Jaut-76/6AQ5-12AX7-stereo-amplifier/12AX7 6AQ5 amp final design.xlsx

Components | 89
Collated Components:
Item | Qty | Reference(s) | Value |  |  | Mouser number | Ebay
1 | 4 | C1, C2, C7, C10 | 20 UF | y |  | 75-TVA1608-E3
2 | 4 | C3, C4, C8, C9 | 25 UF 25V | y |  | 75-TE1207
3 | 4 | C5, C6, C13, C14 | 0.1 UF | y |  | 598-104MWR400K
4 | 2 | C11, C12 | 0.0033 UF | y | 3300pf | 598-332MPW400K
5 | 2 | C15, C16 | 180 PF | y |  | 810-FG24C0G2W181JNT6
6 | 2 | C17, C18 | 0.22 UF | y |  | 598-224MWR400K
7 | 2 | C19, C20 | 270 UF 450V | ebay |  | na | https://www.ebay.co.uk/itm/251902384596?
8 | 1 | C21 | 22 UF 450V | y |  | 80-ESK226M450AM7AA
9 | 2 | C22, C23 | 4.7 UF | y |  | 598-475TTA450M (https://www.mouser.co.uk/ProductDetail/598-475TTA450M)
10 | 2 | C24, C25 | C
11 | 2 | C26, C27 | 0.047 UF | y |  | 539-150400V.047K
12 | 2 | C28, C29 | 22 Uf 100v | y |  | 598-226TTA100M
13 | 2 | D1, D2 | 1N4007 | y |  | 583-RL1N4007-T
14 | 1 | F1 | Fuse | home
15 | 1 | J1 | L PHONO IN | y |  | 179-RCJ-035
16 | 1 | J2 | R PHONO IN | x
17 | 1 | J3 | Mains in | home
18 | 1 | J4 | L AUX 1 | x
19 | 1 | J7 | R AUX 1 | x
20 | 1 | J8 | L SPK OUT | y |  | 474-PRT-09739
21 | 1 | J9 | R SPK OUT | y |  | 474-PRT-09740
22 | 1 | LA1 | Lamp | ebay |  |  | https://www.ebay.co.uk/itm/185698490495?
23 | 2 | R1, R2 | PICKUP RES | y |  | 603-CFR50SJT-26-47K
24 | 4 | R3, R4, R11, R12 | 2700 | y |  | 603-CFR-50JR-52-2K7
25 | 4 | R5, R6, R9, R10 | 0.1 M | y |  | 603-MFR50SJT-52-100K
26 | 2 | R7, R8 | 39000 | y |  | 603-FCR50SJT-52-39K (https://www.mouser.co.uk/ProductDetail/603-FCR50SJT-52-39K)
27 | 2 | R13, R14 | 0.47 M | y |  | 603-CFR50SJT-52-470K
28 | 2 | R15, R16 | 15000 1W | y |  | 594-5083NW15K00J
29 | 2 | R17, R18 | 0.68 M | y |  | 603-CFR50SJT-26-680K (https://www.mouser.co.uk/ProductDetail/603-CFR50SJT-26-680K)
30 | 2 | R20, R21 | 22000 | y |  | 660-CF1/2CT52R223J
31 | 1 | R23 | 250 Ohm 10W | y |  | 588-20J250E
32 | 2 | R24, R25 | 4.7K | y |  | 603-CFR50SJR-52-4K7 (https://www.mouser.co.uk/ProductDetail/603-CFR50SJR-52-4K7)
33 | 2 | R26, R29 | 2.2K | y |  | 603-CFR50SJR-52-2K2
34 | 2 | R27, R28 | 220 | y |  | 603-CFR50SJT-52-220R
35 | 2 | R30, R31 | 150K | y |  | 603-CFR50SJR-52-150K (https://www.mouser.co.uk/ProductDetail/603-CFR50SJR-52-150K)
36 | 2 | R32, R33 | 2.7K | y |  | 603-CFR-50JR-52-2K7
37 | 2 | R34, R35 | 510K | y |  | 603-CFR50SJT-26-510K
38 | 2 | R36, R37 | 300 2W | y |  | 603-FMP200JT-52-300R
39 | 1 | R38 | 150 ohm 6W | y |  | 71-G006150R0JE12
40 | 2 | RV1, RV2 | 100K | y |  | 313-2420F-100K
41 | 1 | SW1 | POWER SPST | home
42 | 1 | SW2 | STBY SPST | home
43 | 1 | SW3 | SW_DPDT_x2 | tube town |  |  |  | Tube-Town Store - Alpha step switch 2-pole / 6 positions (https://www.tube-town.net/ttstore/alpha-stufendrehschalter-2-polig-6-positionen.html)
44 | 1 | T1 | Mains transformer | home
45 | 2 | T2, T3 | 5K Pri - 8 Sec | home
46 | 3 | U1, U2, U3 | ECC83 | home
47 | 2 | U4, U5 | 6AQ5 | home
 |  |  | chassis | tube town |  |  |  | Tube-Town Store - Chassis AL 1444-17132 (https://www.tube-town.net/ttstore/chassis-al-1444-17132.html)
 |  |  | b9a | tube town |  |  |  | Tube-Town Store - Socket Noval Belton, Chassis VT9-ST-2 (https://www.tube-town.net/ttstore/product_info.php?no_boost=1)
 |  |  | b7a | tube town |  |  |  | Tube-Town Store - Socket 7-pin ceramic chassis - 7EK (https://www.tube-town.net/ttstore/sockel-7-polig-keramik-chassis-7ek.html)
 |  |  | knobs | tube town |  |  |  | Tube-Town Store - Button Chickenhead domed, black (https://www.tube-town.net/ttstore/knopf-chickenhead-gewoelbt-schwarz.html)
