Jaut-76/6AQ5-12AX7-stereo-amplifier/12AX7 6AQ5 amp final design.kicad_sch

## KiCad design 12AX7 6AQ5 amp final design.kicad_sch (2023-09-06)

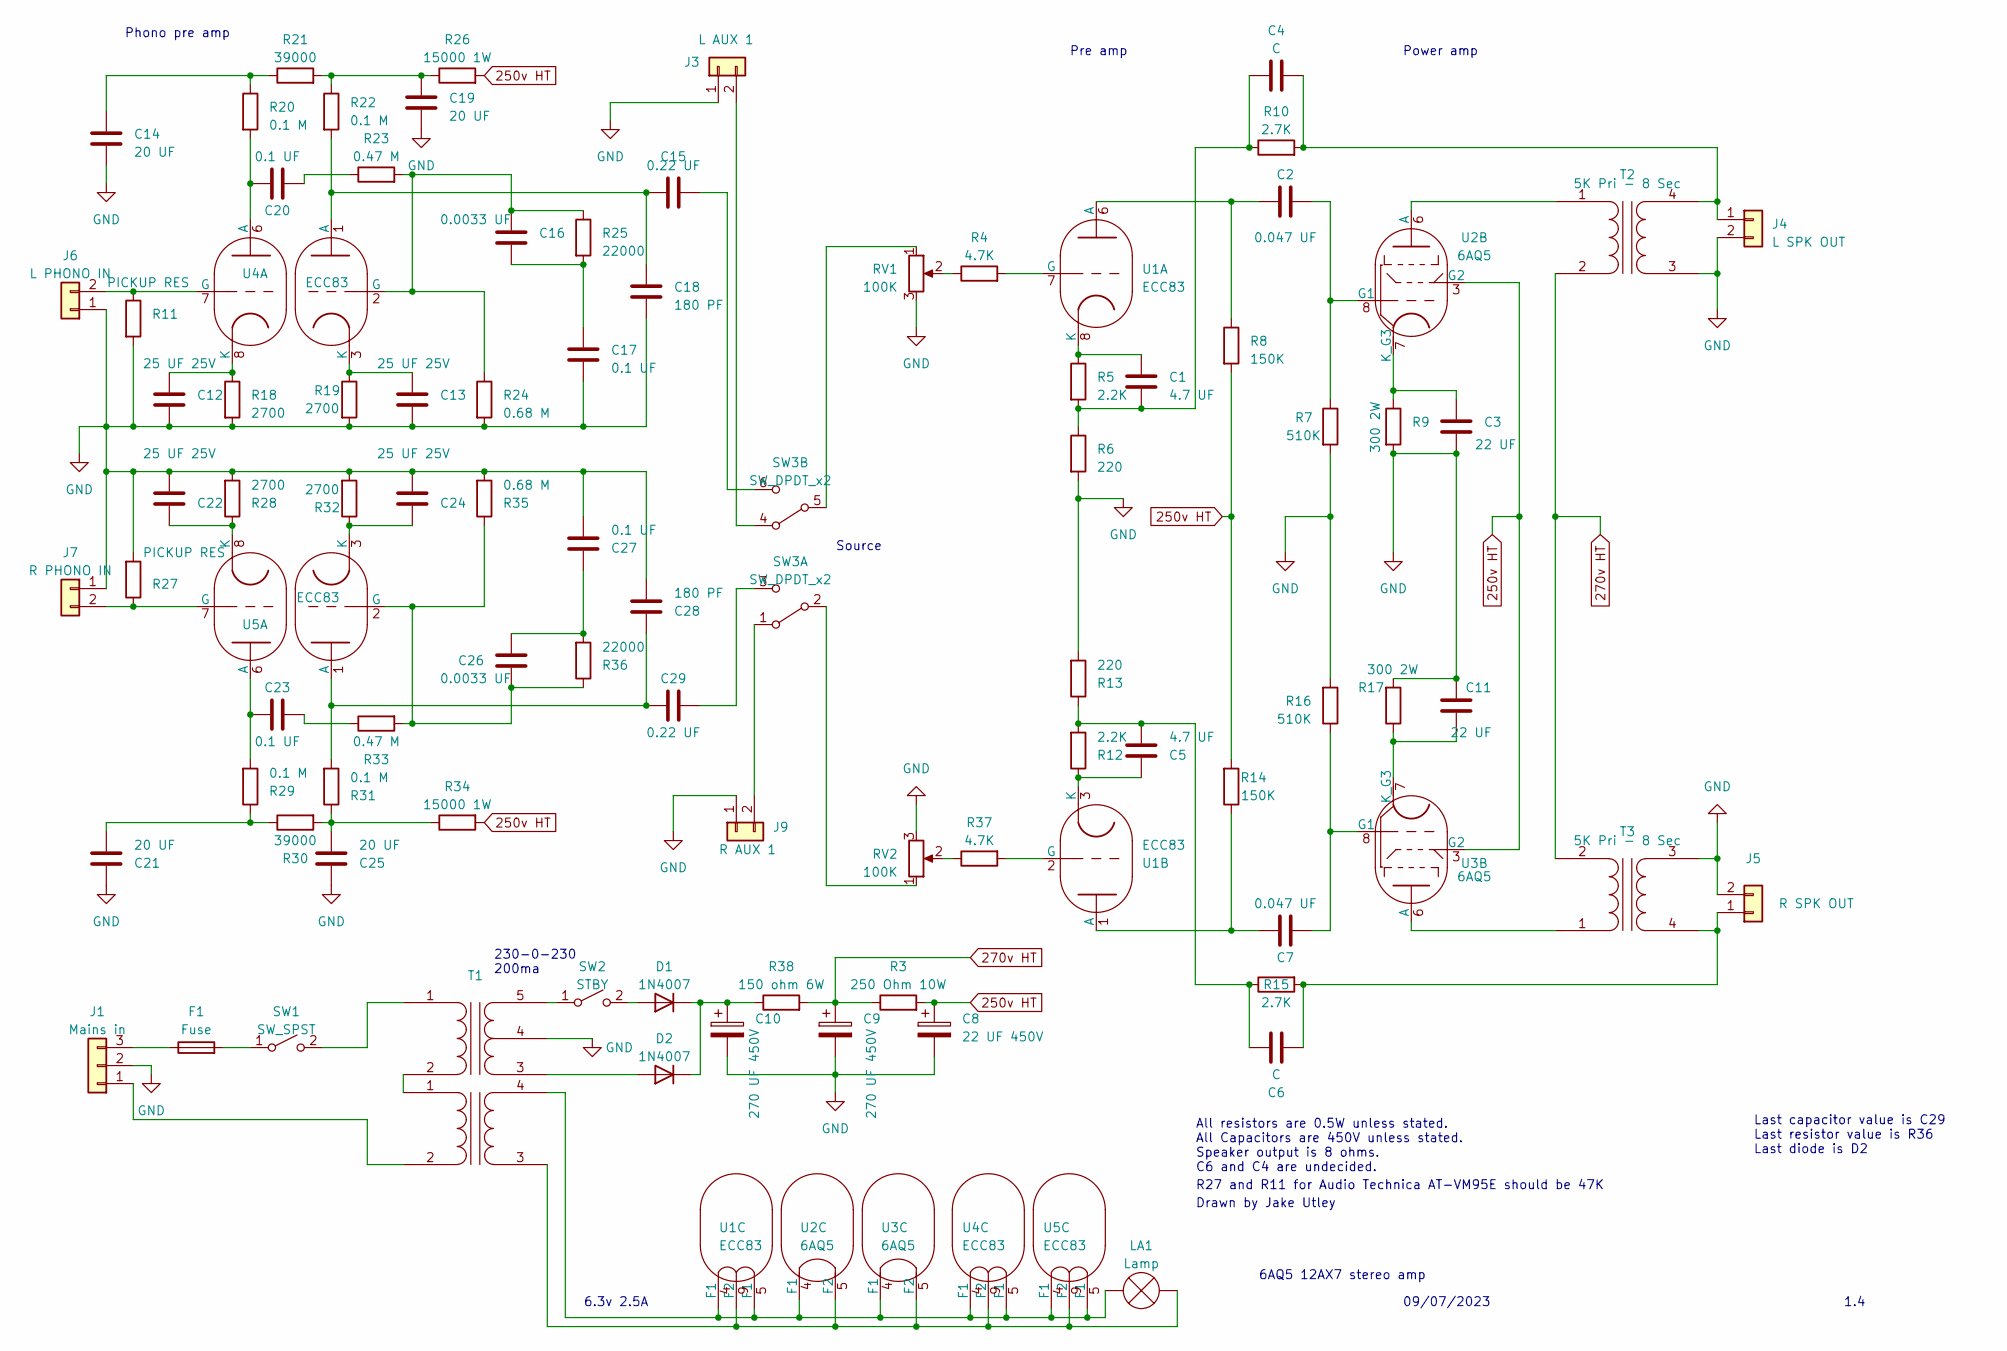
[picture p1: schematic 12AX7 6AQ5 amp final design.kicad_sch]

Parts:
C1, C5: 4.7 UF
C2, C7: 0.047 UF
C3, C11: 22 UF
C4, C6: C
C8: 22 UF 450V
C9, C10: 270 UF 450V
C12, C13, C22, C24: 25 UF 25V
C14, C19, C21, C25: 20 UF
C15, C29: 0.22 UF
C16, C26: 0.0033 UF
C17, C20, C23, C27: 0.1 UF
C18, C28: 180 PF
D1, D2: 1N4007
F1: Fuse
J1: Mains in
J3: L AUX 1
J4: L SPK OUT
J5: R SPK OUT
J6: L PHONO IN
J7: R PHONO IN
J9: R AUX 1
LA1: Lamp
R3: 250 Ohm 10W
R4, R37: 4.7K
R5, R12: 2.2K
R6, R13: 220
R7, R16: 510K
R8, R14: 150K
R9, R17: 300 2W
R10, R15: 2.7K
R11, R27: PICKUP RES
R18, R19, R28, R32: 2700
R20, R22, R29, R31: 0.1 M
R21, R30: 39000
R23, R33: 0.47 M
R24, R35: 0.68 M
R25, R36: 22000
R26, R34: 15000 1W
R38: 150 ohm 6W
RV1, RV2: 100K
SW1: SW_SPST
SW2: STBY
SW3: SW_DPDT_x2
T1: Transformer_1P_SS
T2, T3: 5K Pri - 8 Sec
T4: Transformer_1P_1S
U1, U4, U5: ECC83; Valve_Noval_P
U2, U3: 6AQ5; Valve_Noval_P

Connections:
250v HT: C8.1, R3.2, R8.2, R14.2, R26.2, R34.2, U2.3 (G2), U3.3 (G2)
270v HT: C9.1, R3.1, R38.2, T2.2 (AB), T3.2 (AB)
GND: C3.2, C8.2, C9.2, C10.2, C11.2, C12.2, C13.2, C14.2, C17.2, C18.2, C19.2, C21.1, C22.2, C24.2, C25.1, C27.2, C28.2, J1.2, J3.1, J4.2, J5.2, J6.1, J7.1, J9.1, R6.2, R7.2, R9.2, R11.2, R13.2, R16.2, R17.2, R18.2, R19.2, R24.2, R27.2, R28.2, R32.2, R35.2, RV1.3, RV2.3, T1.4 (SC), T2.3 (SA), T3.3 (SA)
unnamed: C1.1, R5.1, U1.8 (K)
unnamed: C1.2, C4.1, R5.2, R6.1, R10.1
unnamed: C2.1, R8.1, U1.6 (A)
unnamed: C2.2, R7.1, U2.8 (G1)
unnamed: C3.1, R9.1, U2.7 (K_G3)
unnamed: C4.2, J4.1, R10.2, T2.4 (SB)
unnamed: C5.1, R12.1, U1.3 (K)
unnamed: C5.2, C6.1, R12.2, R13.1, R15.1
unnamed: C6.2, J5.1, R15.2, T3.4 (SB)
unnamed: C7.1, R14.1, U1.1 (A)
unnamed: C7.2, R16.1, U3.8 (G1)
unnamed: C10.1, D1.1 (K), D2.1 (K), R38.1
unnamed: C11.1, R17.1, U3.7 (K_G3)
unnamed: C12.1, R18.1, U4.8 (K)
unnamed: C13.1, R19.1, U4.3 (K)
unnamed: C14.1, R20.1, R21.1
unnamed: C15.1, C18.1, R22.2, U4.1 (A)
unnamed: C15.2, SW3.6 (C)
unnamed: C16.1, R23.2, R24.1, R25.1, U4.2 (G)
unnamed: C16.2, C17.1, R25.2
unnamed: C19.1, R21.2, R22.1, R26.1
unnamed: C20.1, R20.2, U4.6 (A)
unnamed: C20.2, R23.1
unnamed: C21.2, R29.1, R30.1
unnamed: C22.1, R28.1, U5.8 (K)
unnamed: C23.1, R29.2, U5.6 (A)
unnamed: C23.2, R33.1
unnamed: C24.1, R32.1, U5.3 (K)
unnamed: C25.2, R30.2, R31.1, R34.1
unnamed: C26.1, R33.2, R35.1, R36.1, U5.2 (G)
unnamed: C26.2, C27.1, R36.2
unnamed: C28.1, C29.1, R31.2, U5.1 (A)
unnamed: C29.2, SW3.3 (C)
unnamed: D1.2 (A), SW2.2 (B)
unnamed: D2.2 (A), T1.3 (SA)
unnamed: F1.1, J1.3
unnamed: F1.2, SW1.1 (A)
unnamed: J1.1, T4.2 (AB)
unnamed: J3.2, SW3.4 (A)
unnamed: J6.2, R11.1, U4.7 (G)
unnamed: J7.2, R27.1, U5.7 (G)
unnamed: J9.2, SW3.1 (A)
unnamed: LA1.1 (-), T4.3 (SA), U1.9 (F2), U2.5 (F2), U3.5 (F2), U4.9 (F2), U5.9 (F2)
unnamed: LA1.2 (+), T4.4 (SB), U1.4 (F1), U1.5 (F1), U2.4 (F1), U3.4 (F1), U4.4 (F1), U4.5 (F1), U5.4 (F1), U5.5 (F1)
unnamed: R4.1, RV1.2
unnamed: R4.2, U1.7 (G)
unnamed: R37.1, RV2.2
unnamed: R37.2, U1.2 (G)
unnamed: RV1.1, SW3.5 (B)
unnamed: RV2.1, SW3.2 (B)
unnamed: SW1.2 (B), T1.1 (AA)
unnamed: SW2.1 (A), T1.5 (SB)
unnamed: T1.2 (AB), T4.1 (AA)
unnamed: T2.1 (AA), U2.6 (A)
unnamed: T3.1 (AA), U3.6 (A)

Notes on the sheet:
6.3v 2.5A
230-0-230 200ma
6AQ5 12AX7 stereo amp
Last capacitor value is C29 Last resistor value is R36 Last diode is D2
R27 and R11 for Audio Technica AT-VM95E should be 47K
Drawn by Jake Utley
Phono pre amp
1.4
All resistors are 0.5W unless stated. All Capacitors are 450V unless stated. Speaker output is 8 ohms. C6 and C4 are undecided.
Power amp
Pre amp
09/07/2023
Source
